PedroMatumoto/kirby/README.md

# Kirby

**Kirby** é o projeto semestral da disciplina **Microcontroladores e Sistemas Embarcados** (EEN251) do **Instituto Mauá de Tecnologia** (IMT), ministrada pelos professores [Sergio Ribeiro Augusto](https://www.linkedin.com/in/sergio-ribeiro-augusto-258a9ba0/?originalSubdomain=br) e [Rodrigo França](https://www.linkedin.com/in/rodrigo-fran%C3%A7a-847872b1/).<BR>

## Sumário

- [Requisitos](#requisitos)
- [Escopo](#escopo)
  - [Diagrama de blocos](#diagrama-de-blocos)
  - [Tecnologias](#tecnologias-e-conceitos)
  - [Materiais](#materiais)
  - [Modelagem eletrônica](#modelagem-eletrônica)
  - [Modelagem mecânica](#modelagem-mecânica)
  - [Modelagem financeira](#modelamento-financeiro)
- [Funcionamento](#funcionamento)
  - [Máquina de estados](#máquina-de-estados)
    - [Estados](#estados)
- [Testes](#testes)
- [Ressalvas](#ressalvas)
- [Vídeo de funcionamento](#vídeo-de-funcionamento)
  - [Funcioamento simples](#seguidor-básico)
  - [Funcionamento do sensor de cor](#sensor-de-cor)
  - [Funcionamento com a parte de baixo](#parte-de-baixo)
  - [Funcionamento completo](#completo)
- [Foto da equipe](#foto-da-equipe)
- [Autores](#autores)

# Requisitos

| id  | requisito | tipo |
| --- | --- | --- |
| 1 | Utilizar sensores analógicos ou digitais | Técnico |
| 2 | Servir bebidas aos clientes | Funcional |
| 3 | Seguir um trajeto no chão | Funcional |
| 4 | Verificar o abastecimento dos tanques para evitar uso incorreto dos motores | Técnico |
| 5 | Utilizar um microcontrolador | Técnico |
| 6 | Utilizar padrões de conexão (I2C, SPI) vistos em aula | Técnico |
| 7 | Interagir com o usuário por meio de botões | Técnico |

# Escopo

O projeto consiste em um robô autônomo que deve **seguir uma linha no chão**, **mudar de estado conforme a leitura de cores do sensor** e **interagir com o usuário através de botões**. O robô deve ser capaz de carregar dois tipos de líquidos em seus tanques e servir o usuário conforme a interação.

## Diagrama de blocos

<p align="center">
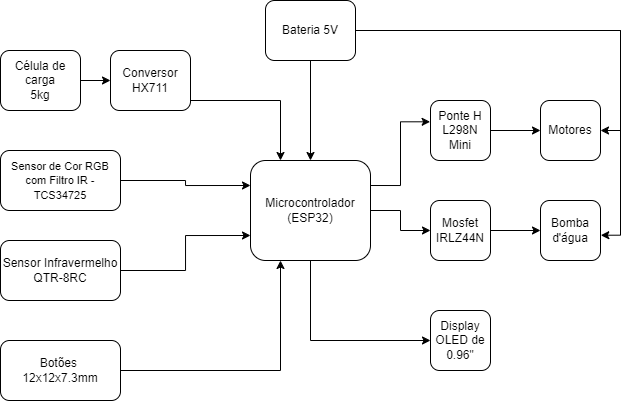
[picture p1: assets/diagrama_blocos.png]
diagrama de blocos
  
</p>

## Tecnologias e conceitos

- I2C (Comunicação com os displays e sensores)
- Transistores (MOSFET/Ponte H)
- PWM (Controle do motor)
- Autômatos (Lógica de funcionamento)
- PIO (Entrada e saída do microcontrolador)

## Materiais

O robô é montado a partir dos seguintes materiais:

- 1 microcontrolador **ESP32**
- 2 células de Carga de 5kg
- 2 conversores **HX711**
- 2 MOSFETs **IRLZ44N**
- 1 sensor de cor **TCS34725**
- 2 sensores de linha **QTR-8RC**
- 1 chassi de acrílico
- 1 ponte H L298N Mini
- 2 motores **3-6 V**
- 2 mini bombas
- 2 displays **OLED** I2C
- 3 botões
- Filamento ABS
- 2 Pilhas recarregáveis do Lítio
- Suporte para a bateria
- Regulador de tensão (LM2596 DC-DC)

## Modelagem eletrônica

O circuito utiliza diversos conceitos eletrícos e eletrônicos desenvolvidos durante o curso e em entidades acâdemicas relacionadas, como:

- MOSFETs para ativação das bombas
- Ponte H já fabricada para controle PWM dos motores
- Displays e sensores com comunicação I2C
- Conversão de sinais
- Regulação de tensão

<p align="center">
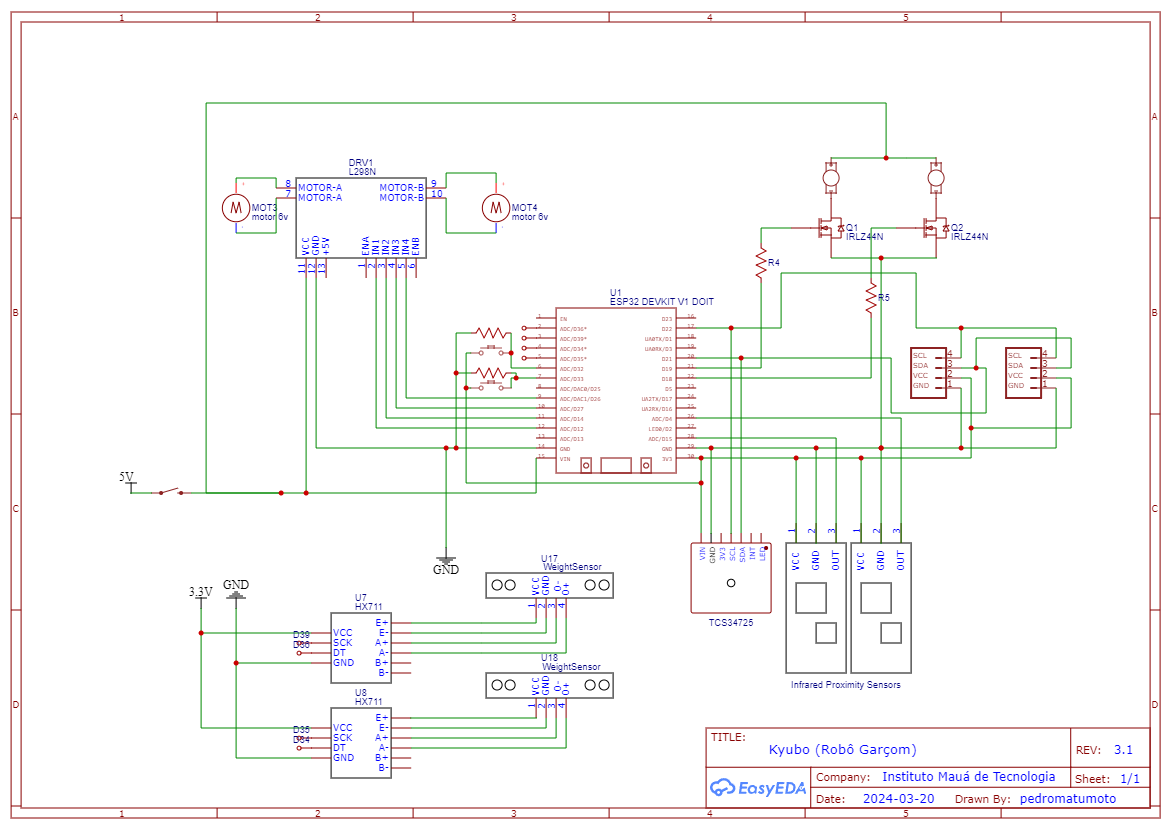
[picture p2: assets/Schematic_kyubo_shared_micro_2024-05-23.png]
diagrama eletronico
  
</p>

## Modelagem mecânica

O projeto, requere certo nível de resistência térmica por parte do material diretamente em contato com a bebida (gelada ou quente), o que nos direcionou para o uso do material ABS, que tem essa propriedade.
Os containeres da bebida ficaram apartados da estrutura para evitar contato com componentes eletrônicos. O circuito elétrico fica próximo dos motores, diminuindo a necessidade de cabeamento extenso. Como o enfoque do projeto não era mecânico, a base para locomoção foi comprada pronta, maximizando o uso do tempo que seria gasto com o modelamento de motores, engrenagens para redução e preocupações com transmissão. Toda a estrutura foi baseada no personagem da Cultura Geek Kirby, protagonista de uma franquia da Nintendo.

<p align="center">
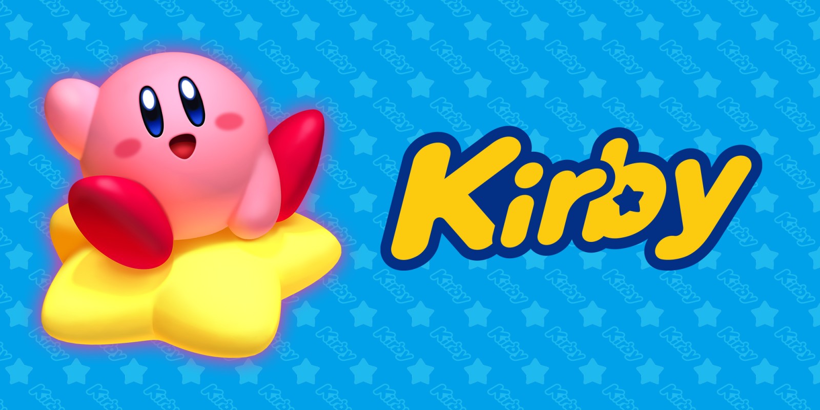
[picture p3: assets/banner_kirby.jpg]
kirby
  
</p>

## Modelamento financeiro

Os componentes do projeto foram financiados inteiramente pelos integrantes do grupo, utilizando-se de materiais previamente obtidos e contribuição para manufatura da placa eletrônica impressa do Instituto Mauá de Tecnologia. Para fins de teste, os equipamentos do Instituto Mauá de Tecnologia como multímetro, fonte e protoboard foram utilizados.<br>
| Item | Preço Unitário (R$) | Quantidade | Preço Total (R$) |
|---|---|---|---|
| Sensor de Cor RGB com Filtro IR - TCS34725 | 28,40 | 1 | 28,40 |
| Célula de Carga 5Kg - Sensor de Peso | 17,90 | 2 | 35,80 |
| Chave DIP Switch 1 Via | 2,50 | 1 | 2,50 |
| Push Button (Chave Táctil) 12x12x7.3mm | 0,90 | 4 | 3,60 |
| Mini Bomba Submersível p/ Água | 12,90 | 2 | 25,80 |
| Módulo Conversor 24bit Hx711 p/ Célula De Carga | 8,90 | 2 | 17,80 |
| Sensor de Obstáculos Reflexivo Infravermelho | 7,90 | 2 | 15,80 |
| Display OLED 128x64 0.96" I2C - Pinos Soldados | 34,90 | 2 | 69,80 |
| Kit Chassi 2WD Robô para Arduino (Modelo 2) | 79,90 | 1 | 79,90 |
| Mini Ponte H Dupla L298N | 7,90 | 1 | 7,90 |
| Capa Redonda para Push Button 12x12x7.3mm (Preto) | 0,50 | 4 | 2,00 |

# Funcionamento

O funcionamento do robô é baseado em uma **máquina de estados** que controla o comportamento do robô conforme a leitura do **sensor infravermelho** e do **sensor de cor**.

Primeiramente, o robô deve ser calibrado para que o sensor de cor consiga identificar a linha no chão. Após a calibração, o robô deve seguir a linha até encontrar a cor verde, onde ele deve parar e interagir com o usuário.

Com a interação do usuário a partir dos botões, o robô deve servir o usuário com o líquido correspondente ao botão selecionado (dois líquidos até o momento). Caso o tanque atinja um **nível crítico**, o robô deve retornar ao ponto inicial (cor azul) e reiniciar o processo.

Os **displays OLED** são utilizados de forma estética para simular o olho do personagem Kirby.

## Depuração

No projeto, a linguagem C/C++ foi utilizada para a aplicação tanto por sua eficiência nesse tipo de caso de uso, quanto pela riqueza de material existente sobre esse tipo de projeto.

A Arduino IDE e as seguintes bibliotecas foram utilizadas para depurar o código

- Wire.h
- Adafruit_TCS34725.h (Sensor de cor)
- HX711.h (Módulo conversor de peso)

## Máquina de estados

<p align="center">
  maquina-estados
</p>

### Estados

- **I**: Estado inicial
- **A**: Estado andando/seguindo
- **P**: Estado parado
- **C**: Estado crítico

# Testes

## Dia 15/05/2024

- **Teste de calibração do sensor de cor**
  - O sensor de cor foi calibrado para identificar a cor verde
- **Teste de calibração do sensor infravermelho**
  - O sensor infravermelho foi calibrado para identificar a linha preta no chão e iniciar o estado de girar
- **Teste de botão**
  - O botão foi testado para identificar a interação do usuário
- **Teste de bomba**
  - A bomba foi testada para identificar a interação do robô com o usuário e bombear o líquido

https://github.com/enzosakamoto/kirby/assets/98707474/40ef3852-a57a-4a14-8359-391d45e8bc85

# Ressalvas

Com o decorrer do projeto, acabamos tendo que mudar algumas coisas do escopo do projeto inicial, devido a dificuldade de reorganizar dentro do espaço pequeno do Kirby. Então, retiramos a feature de dispenser e o projeto acabou funcionando mais como um robô para transferir coisas dentro de si. Ele suporta agora até 10 volts na ponte H e para a ESP.

# Vídeo de funcionamento

## Seguidor básico

https://github.com/PedroMatumoto/kirby/assets/85521574/aaf1a16d-d58f-403c-81cf-5f88884271a1

## Sensor de cor

https://github.com/PedroMatumoto/kirby/assets/85521574/dffed084-cc13-473b-ba64-888f88831c52

## Parte de baixo

https://github.com/PedroMatumoto/kirby/assets/85521574/ca2573db-44cb-4a38-9400-57ee9a864a09

## Completo

https://github.com/PedroMatumoto/kirby/assets/85521574/d881d26d-c9eb-4c51-b02c-57bc47560678

## Foto da equipe

<p align="center">
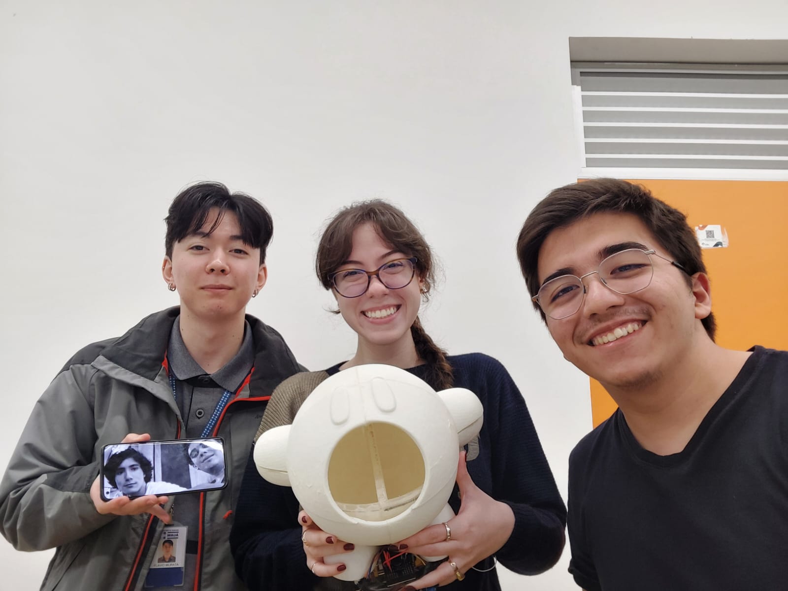
[picture p4: assets/FOTO_EQUIPE.jpg]
  
</p>

# Autores

- [Antonio Ferrite 21.00663-6](https://github.com/tom-ferrite) 
- [Enzo Sakamoto 21.00210-0](https://github.com/enzosakamoto) 
- [Flavio Murata 21.01192-3](https://github.com/flaviomurata)
- [Maria Fernanda Pinho 21.00256-8](https://github.com/mafepinho)
- [Pedro Matumoto 21.00784-5](https://github.com/pedromatumoto)
