PedroMatumoto/kirby/stls/um_aumentado.stl

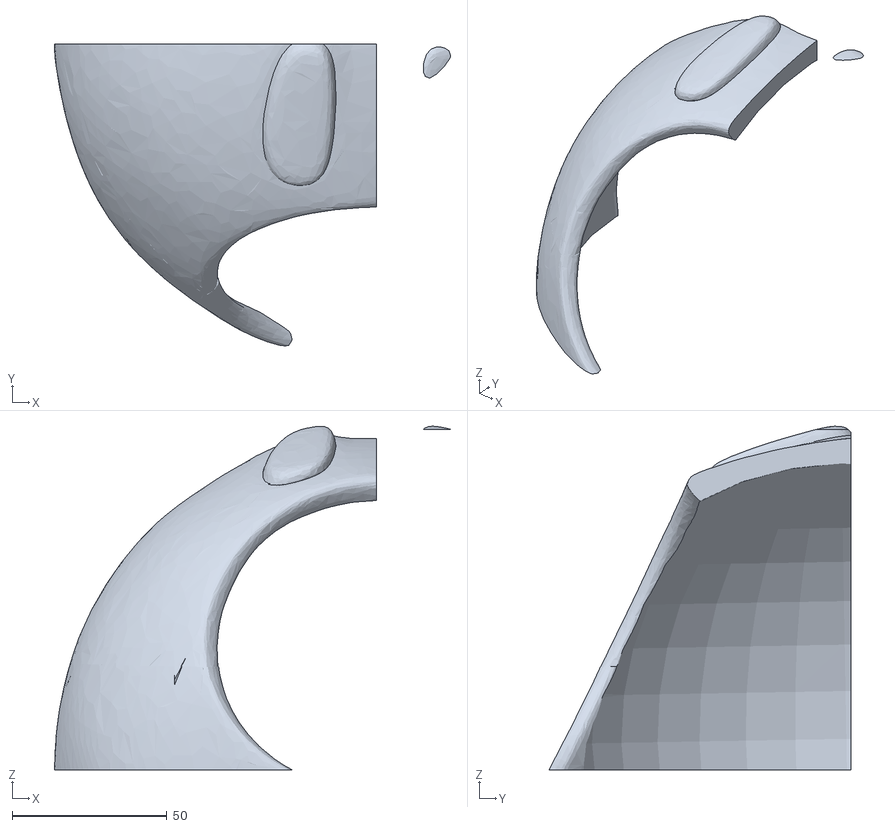
[picture p5: CAD file, 2024-06-05]
stls/um_aumentado.stl
127.9 x 97.5 x 111.0
