PedroMatumoto/kirby/stls/oito_aumentado.stl

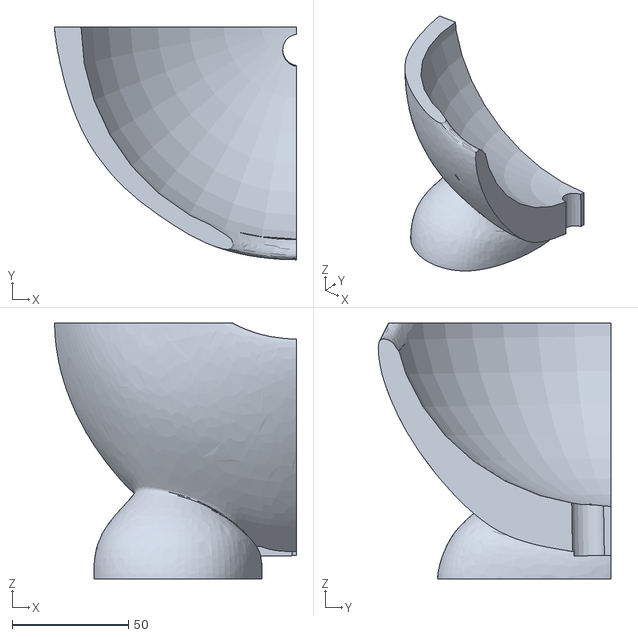
[picture p6: CAD file, 2024-06-05]
stls/oito_aumentado.stl
104.1 x 100.0 x 110.0
