PedroMatumoto/kirby/stls/sete_aumentado.stl

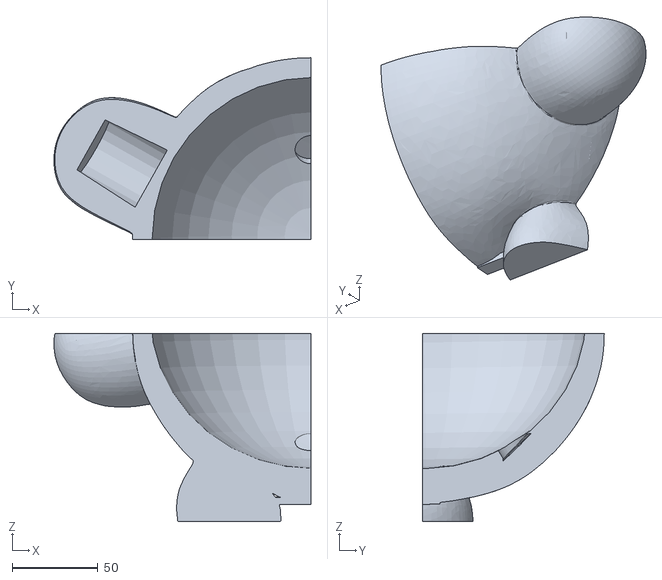
[picture p7: CAD file, 2024-06-05]
stls/sete_aumentado.stl
150.0 x 106.0 x 110.0
