PedroMatumoto/kirby/stls/tres_aumentado.stl

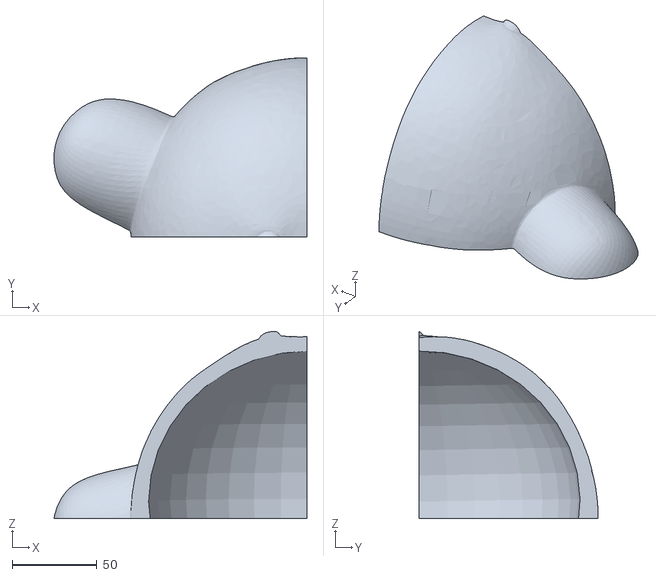
[picture p8: CAD file, 2024-06-05]
stls/tres_aumentado.stl
149.5 x 106.0 x 110.5
