PedroMatumoto/kirby/stls/quatro_aumentado.stl

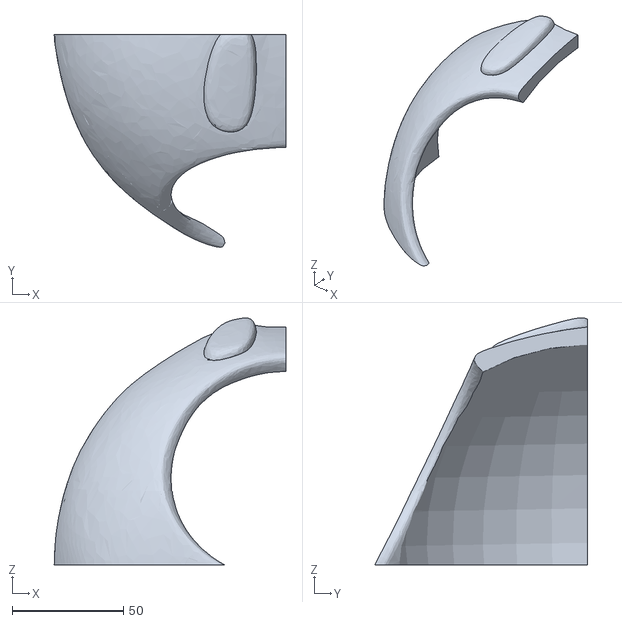
[picture p9: CAD file, 2024-06-05]
stls/quatro_aumentado.stl
104.0 x 95.5 x 111.0
