PedroMatumoto/kirby/stls/seis_aumentado.stl

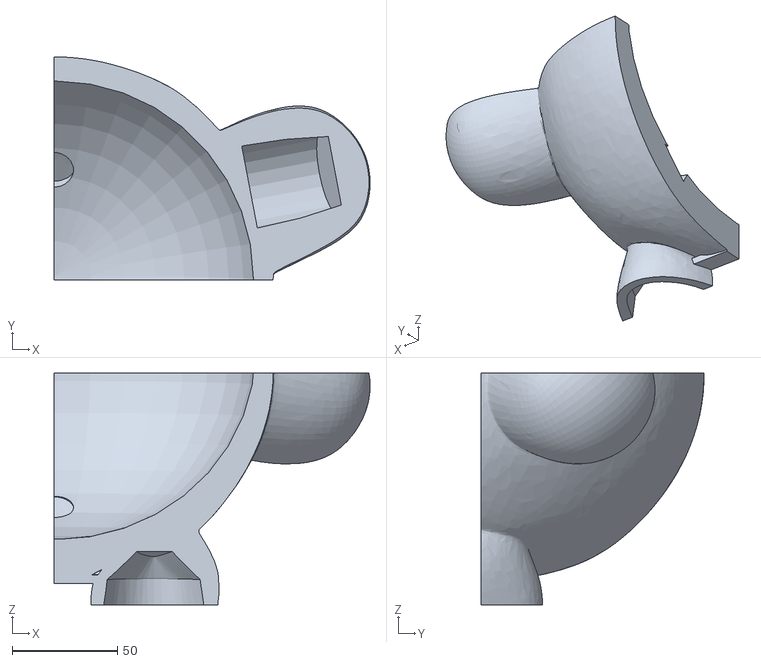
[picture p10: CAD file, 2024-06-05]
stls/seis_aumentado.stl
150.0 x 106.0 x 110.0
