PedroMatumoto/kirby/stls/dois_aumentado.stl

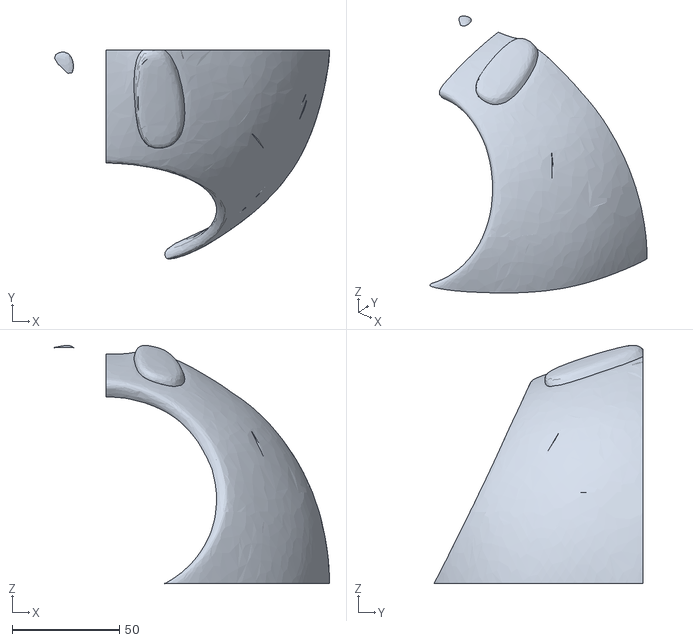
[picture p11: CAD file, 2024-06-05]
stls/dois_aumentado.stl
128.2 x 97.4 x 111.0
