PedroMatumoto/kirby/stls/cinco_aumentado.stl

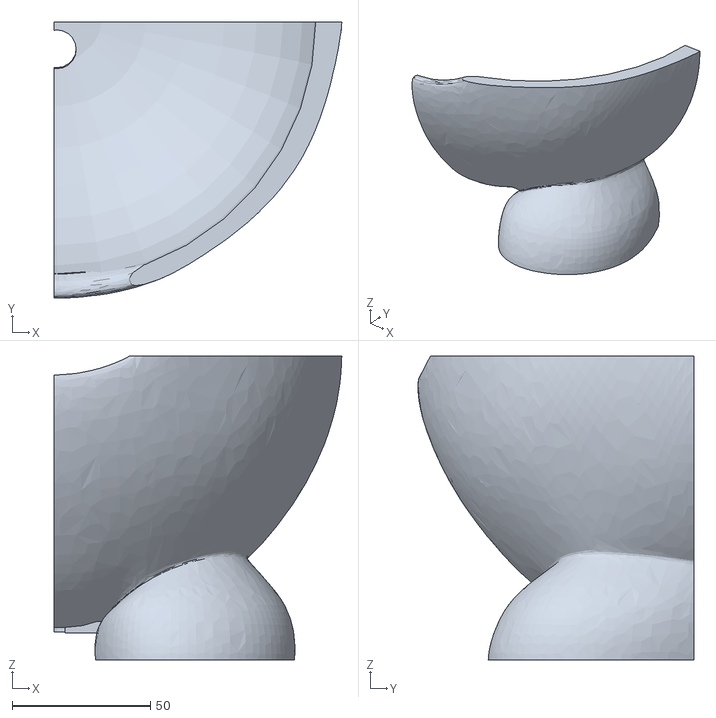
[picture p12: CAD file, 2024-06-05]
stls/cinco_aumentado.stl
104.1 x 100.0 x 110.0
