PedroMatumoto/kirby/(list of files, drawings)

Other design files:
assets/SCH_kyubo_shared_micro_2024-05-23.json
