PedroMatumoto/kirby/(commit log)

2024-04-03 feat(sensor-luz): adiciona leitura do sensor de luz
2024-04-17 adiciona máquina de estados não funcional
2024-04-24 feat: adiciona sensores e a máquina de estados
2024-05-08 feat(motor): adiciona funcionamento e controle de velocidade do motor
2024-05-15 adiciona parametrização do motor e ativação da bomba
2024-05-15 adiciona sensor de peso e conversor
2024-05-17 docs(readme): atualiza readme com foto da máquina de estados
2024-05-19 docs(readme): adiciona tabela de requisitos
2024-05-19 chore(files): adiciona pasta de arquivos
2024-05-19 docs(files): adiciona imagem do diagrama de blocos
2024-05-19 docs(readme): adiciona diagrama de blocos
2024-05-19 docs(readme): atualiza lista de materiais
2024-05-19 docs(readme): adiciona tópicos de tecnologias e depuração
2024-05-19 docs(files): adiciona asset do banner para o readme
2024-05-19 docs(readme): corrige erros de português
2024-05-22 feat(motor): altera a velocidade do motor
2024-05-23 docs(files): adiciona assets e documentação para placa
    [SCH_kyubo_shared_micro_2024-05-23.json]
2024-05-23 fix(code): trocar porta da bomba
    [main.ino]
2024-05-24 feat(code): implementa sensores de peso na lógica
2024-05-28 fear(code): altera sensores de peso para sensores de nível
2024-05-29 feat(code): atualiza configuração para nível
2024-06-05 docs(readme): altera link para o vídeo
2024-06-05 docs(readme): adiciona âncora de funcionamento
2024-06-05 fix(code): altera para código correto
    [main.ino]
2024-06-05 fix(code): atualiza a interação de botões com sensor de cor
    [main.ino]
2024-06-05 docs(readme): adiciona refs para os vídeos
2024-06-05 docs(files): adiciona stls do projeto
    [cinco_aumentado.stl, dois_aumentado.stl, oito_aumentado.stl, quatro_aumentado.stl, seis_aumentado.stl, sete_aumentado.stl, tres_aumentado.stl, um_aumentado.stl]
